landboat/Robot-Olympics/README.md

# Robot-Olympics
Final report from my first year collaborative engineering design project.
